AkaG/FTL/DTR/images/silnik-gora.jpg

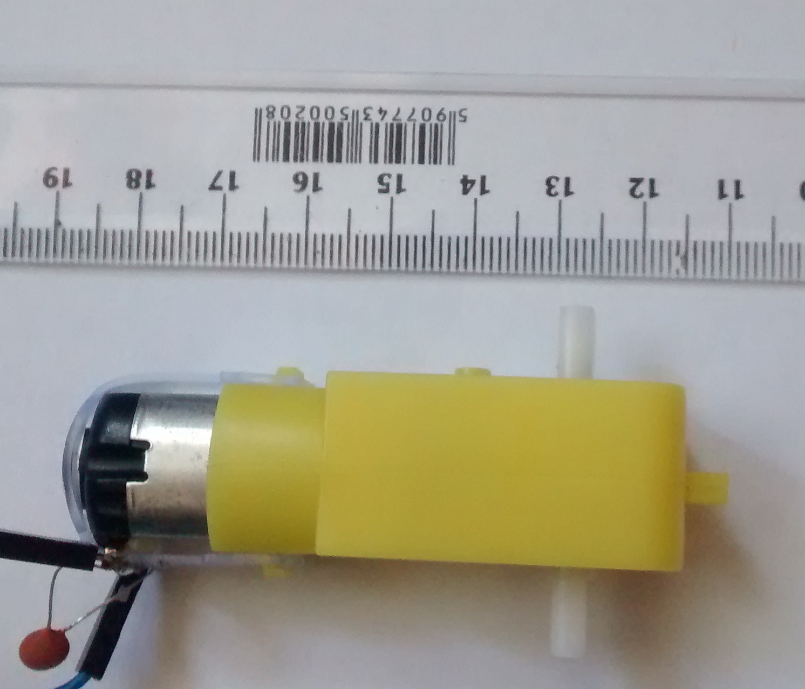
DTR/images/silnik-gora.jpg
