AkaG/FTL/DTR/images/podstawa-3.jpg

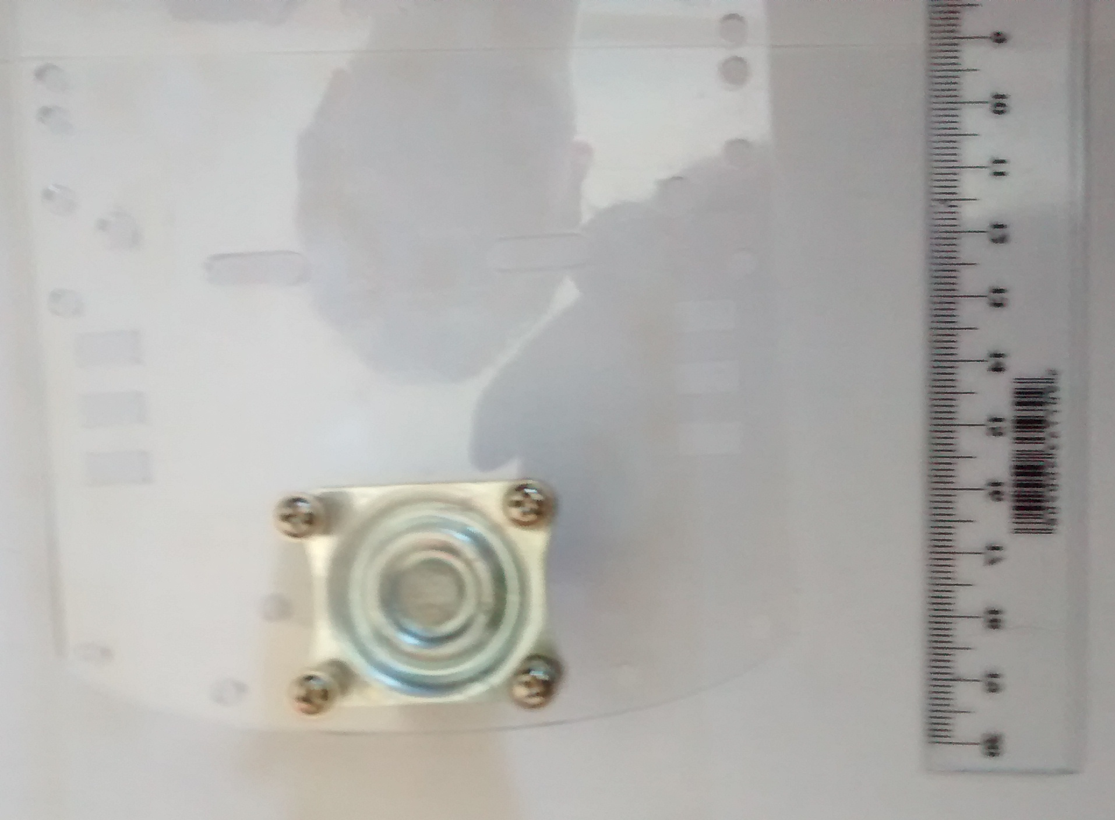
DTR/images/podstawa-3.jpg
