AkaG/FTL/DTR/images/czujnik.jpg

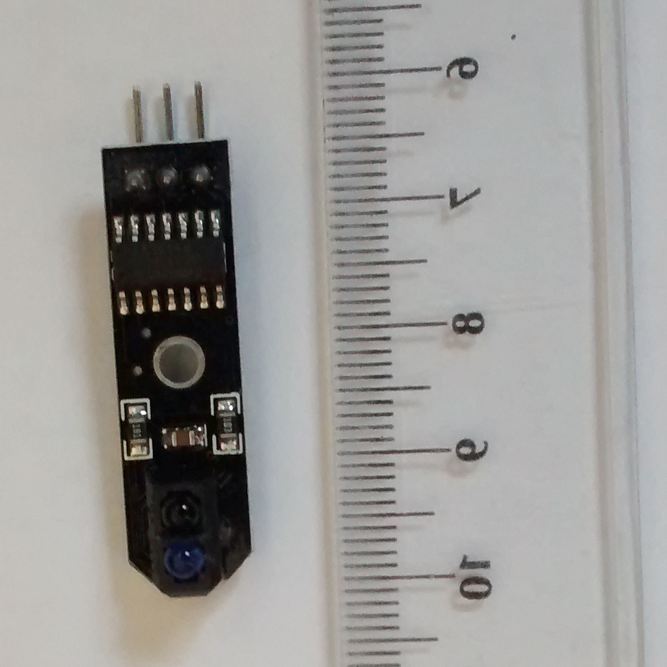
DTR/images/czujnik.jpg
