AkaG/FTL/DTR/images/FTL-B.png

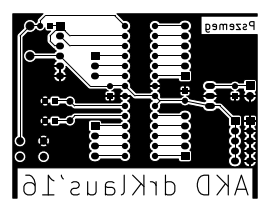
DTR/images/FTL-B.png
