AkaG/FTL/DTR/images/kolo.jpg

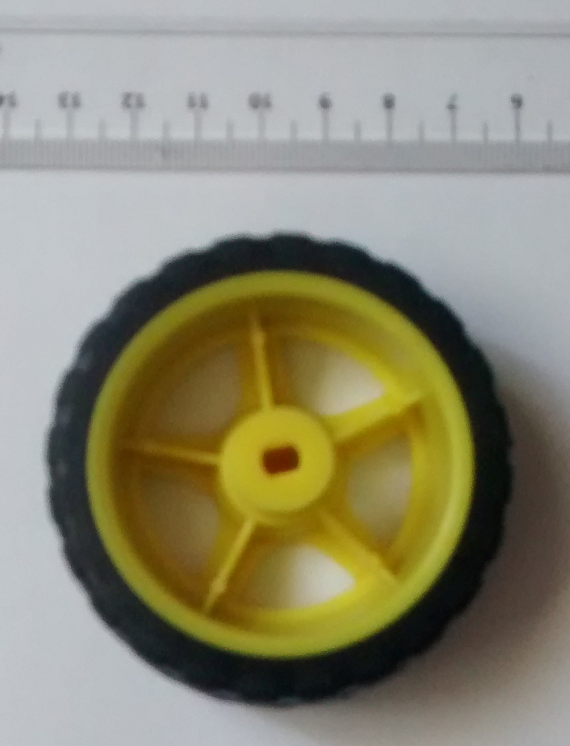
DTR/images/kolo.jpg
