AkaG/FTL/DTR/images/mocowanieCzujnika.jpg

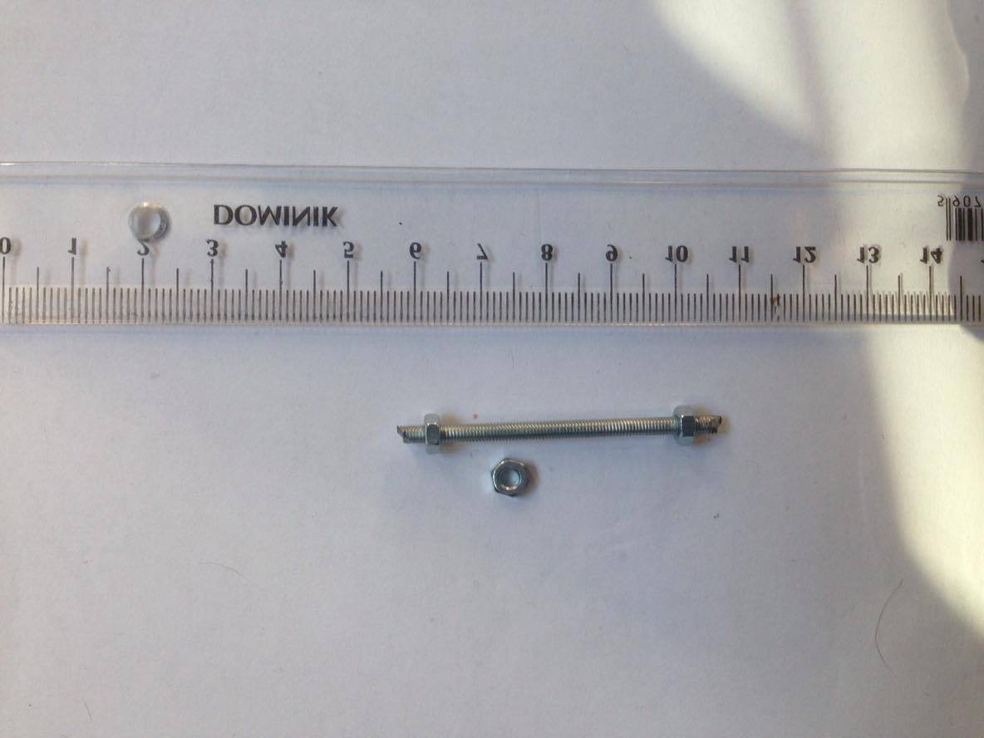
DTR/images/mocowanieCzujnika.jpg
