AkaG/FTL/DTR/images/mocowanieSilnika.jpg

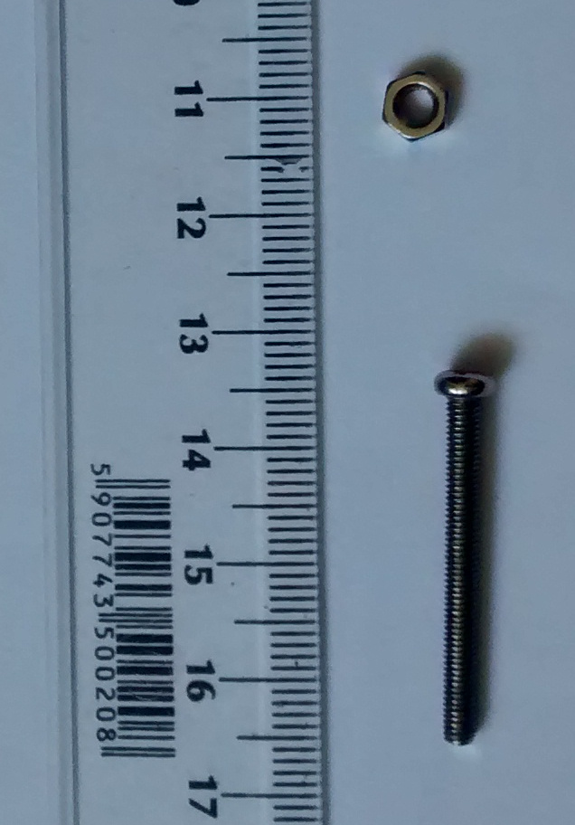
DTR/images/mocowanieSilnika.jpg
