AkaG/FTL/DTR/images/mostek.jpg

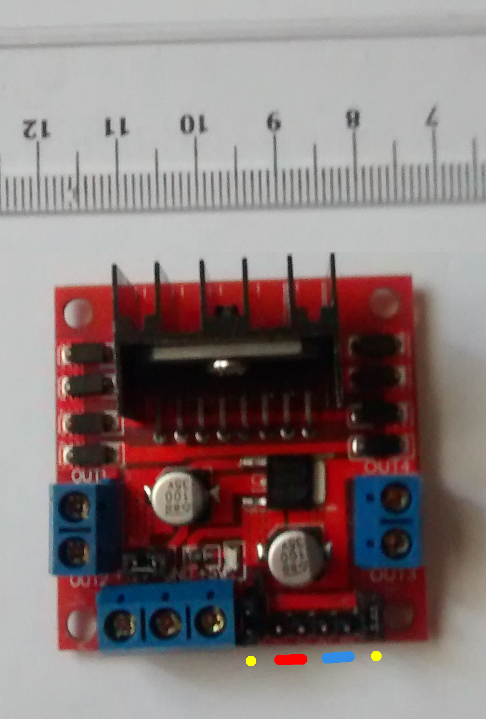
DTR/images/mostek.jpg
