AkaG/FTL/DTR/images/pcb.PNG

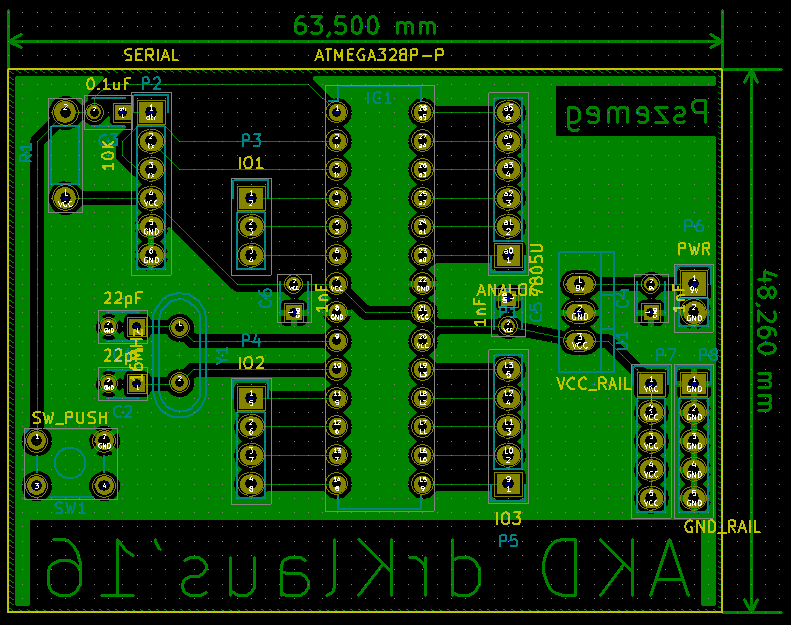
DTR/images/pcb.PNG
