AkaG/FTL/DTR/images/plytka.jpg

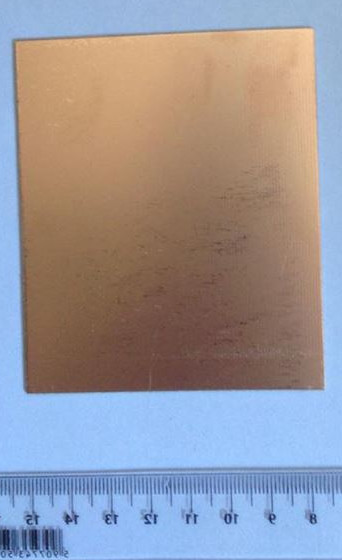
DTR/images/plytka.jpg
