AkaG/FTL/DTR/images/plytkaGotowa.jpg

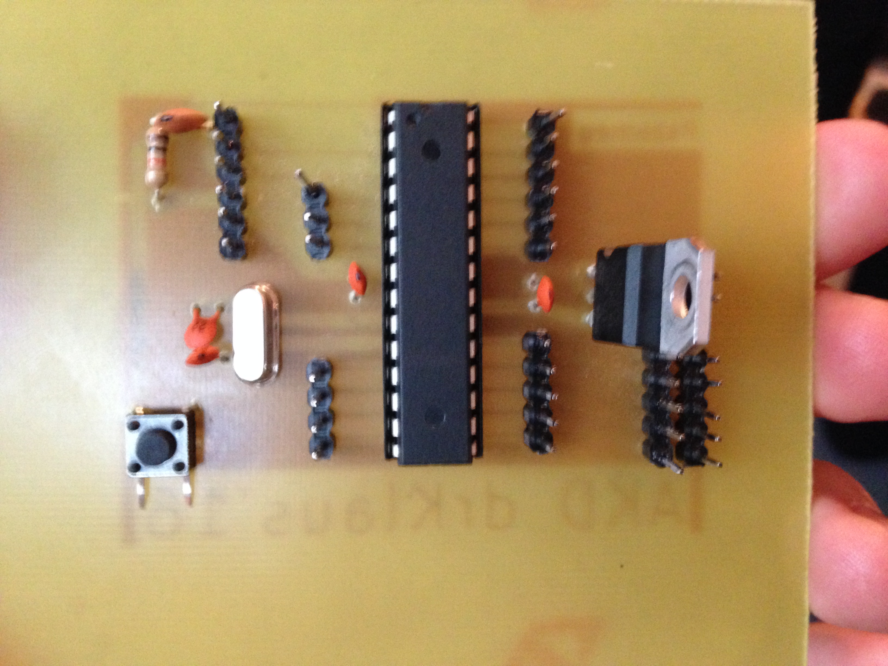
DTR/images/plytkaGotowa.jpg
