AkaG/FTL/DTR/images/podstawa-1.jpg

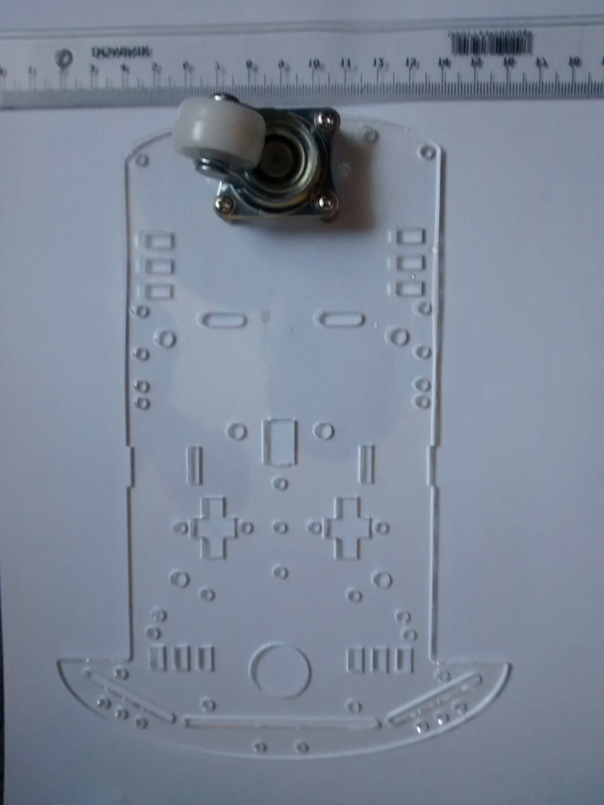
DTR/images/podstawa-1.jpg
