AkaG/FTL/DTR/images/podstawa-2.jpg

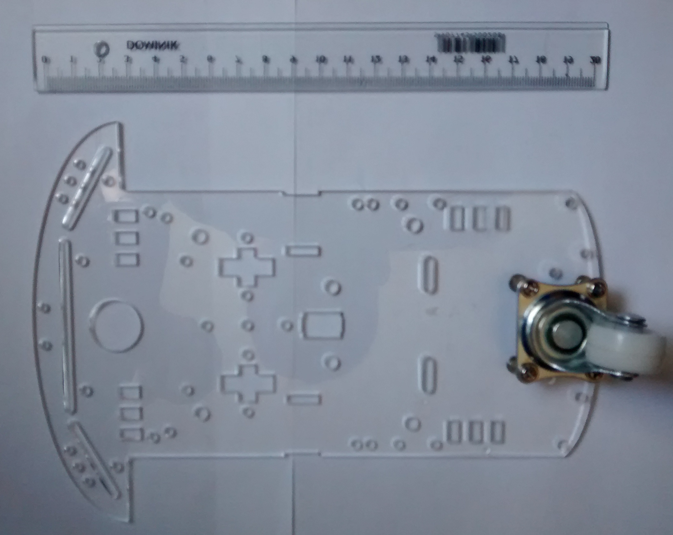
DTR/images/podstawa-2.jpg
