AkaG/FTL/DTR/images/podstawa-4.jpg

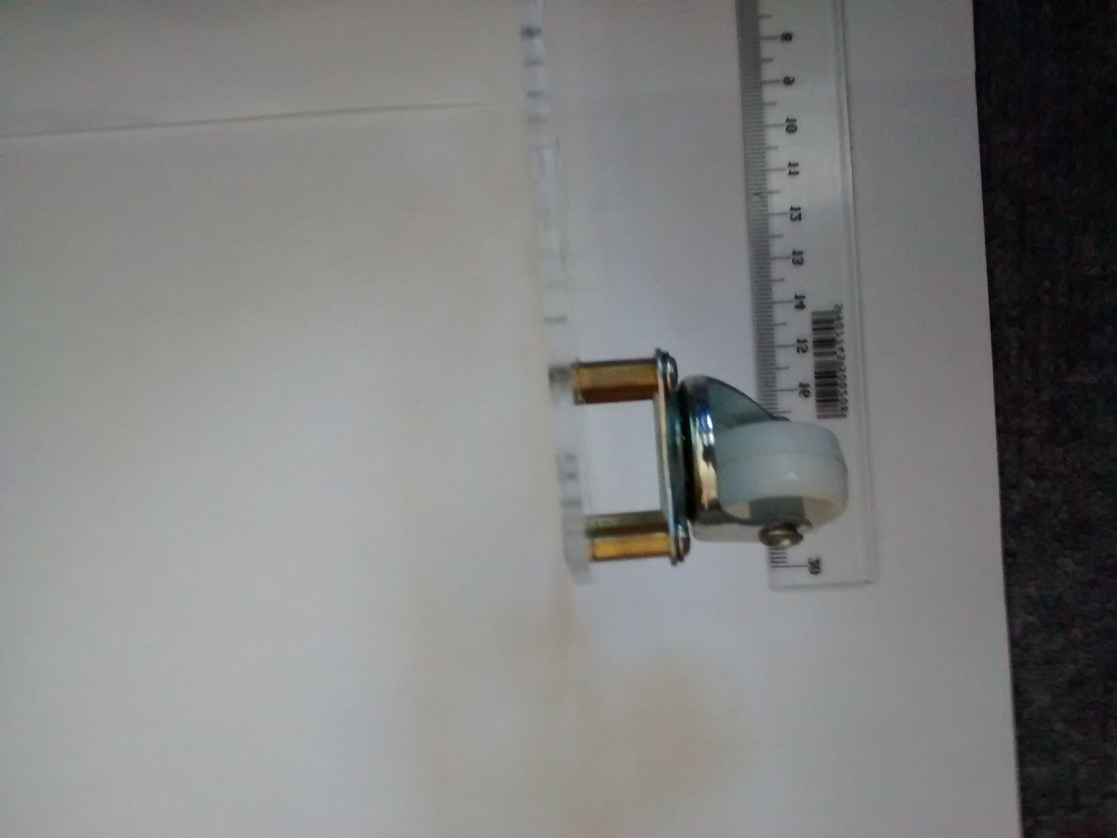
DTR/images/podstawa-4.jpg
