AkaG/FTL/DTR/images/pojemnik-1.jpg

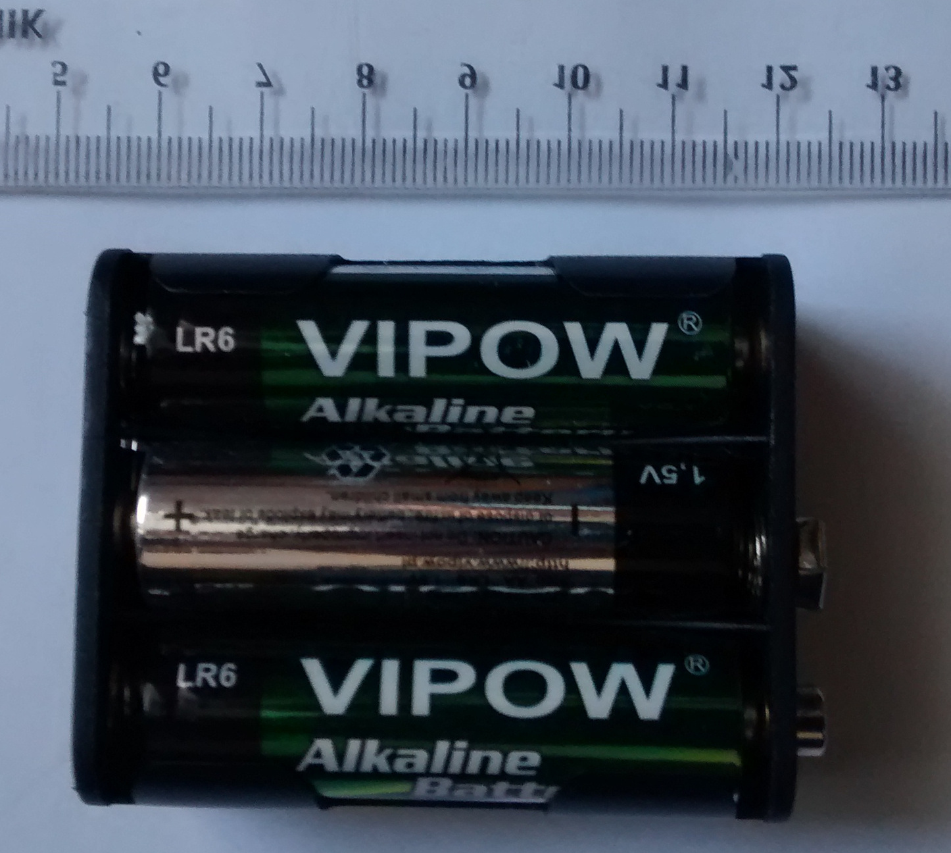
DTR/images/pojemnik-1.jpg
