AkaG/FTL/DTR/images/pojemnik-2.jpg

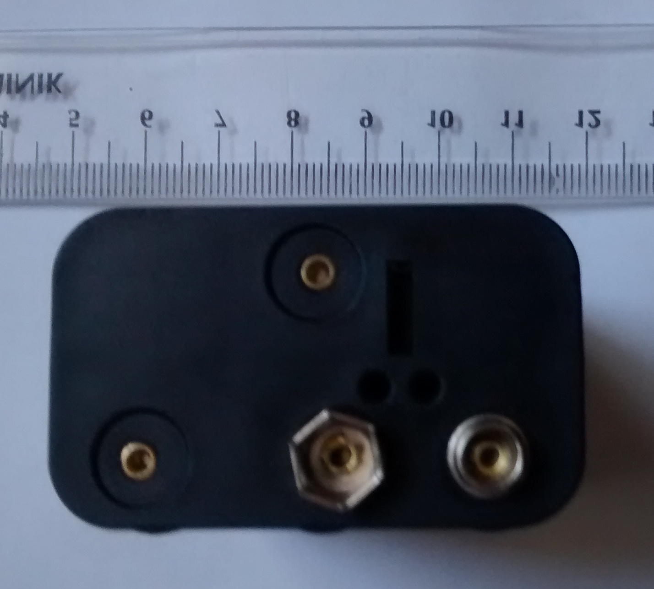
DTR/images/pojemnik-2.jpg
