AkaG/FTL/DTR/images/Pszemeg.jpg

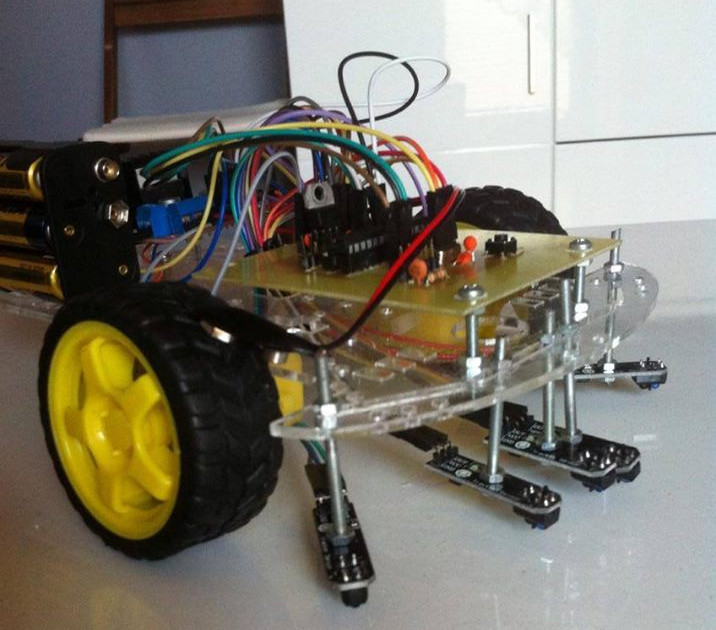
DTR/images/Pszemeg.jpg
