AkaG/FTL/DTR/images/schemat.PNG

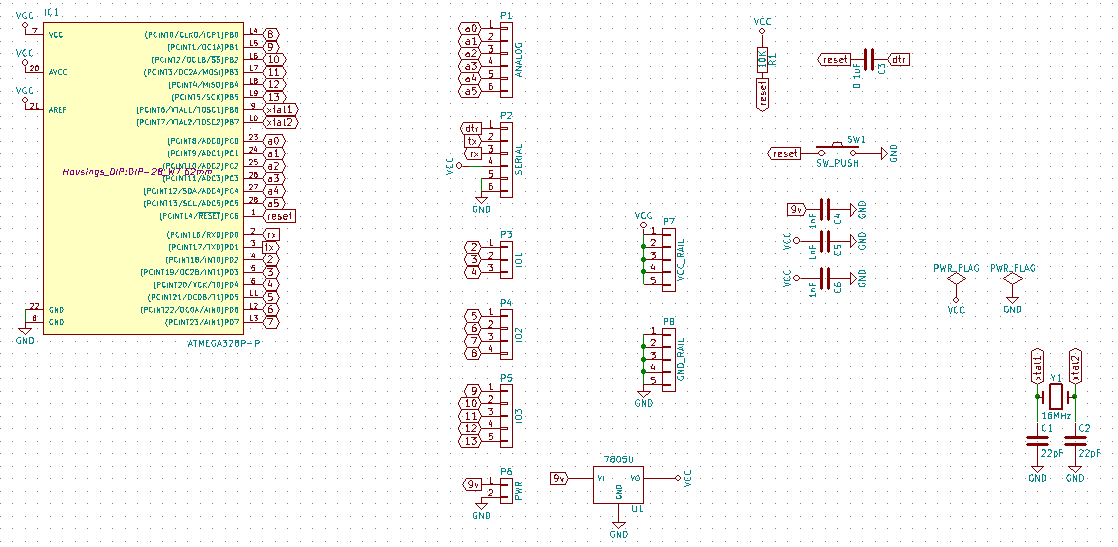
DTR/images/schemat.PNG
