AkaG/FTL/DTR/images/silnik-bok.jpg

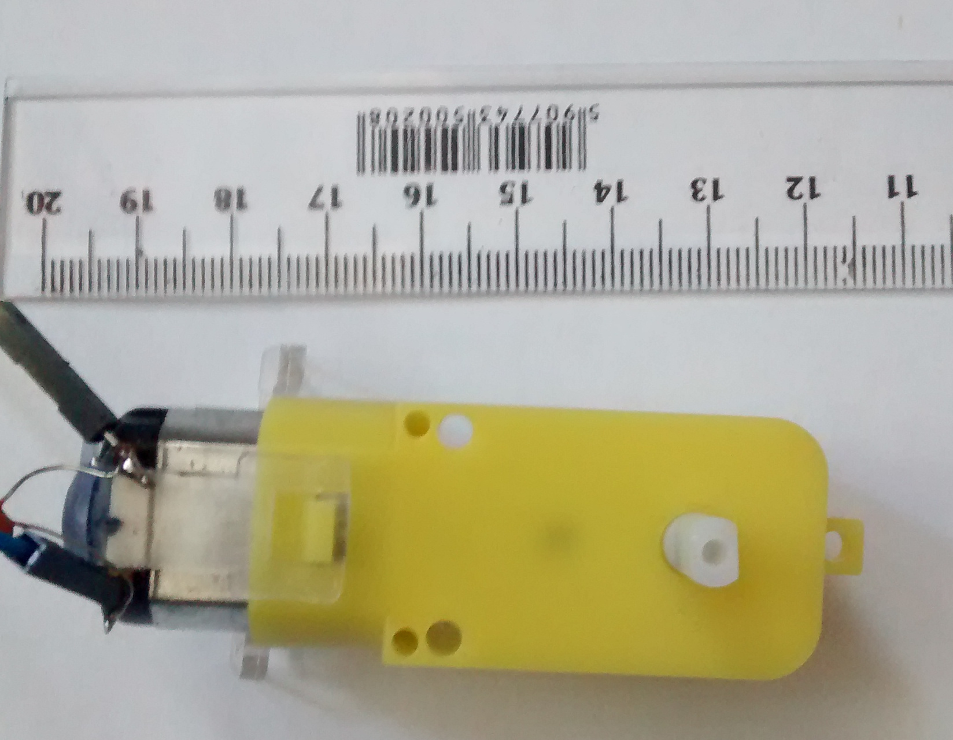
DTR/images/silnik-bok.jpg
