AkaG/FTL/DTR/images/temp.png

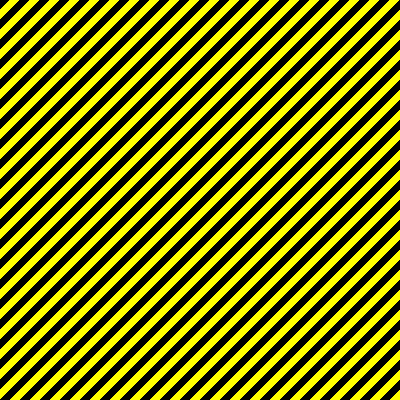
DTR/images/temp.png
