AkaG/FTL/DTR/images/termotransfer-1.jpg

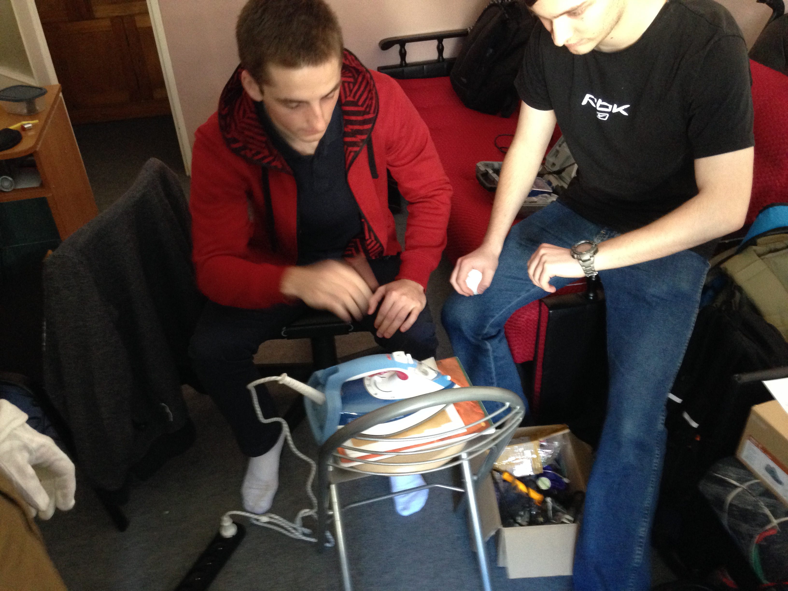
DTR/images/termotransfer-1.jpg
