AkaG/FTL/DTR/images/trzymacze.jpg

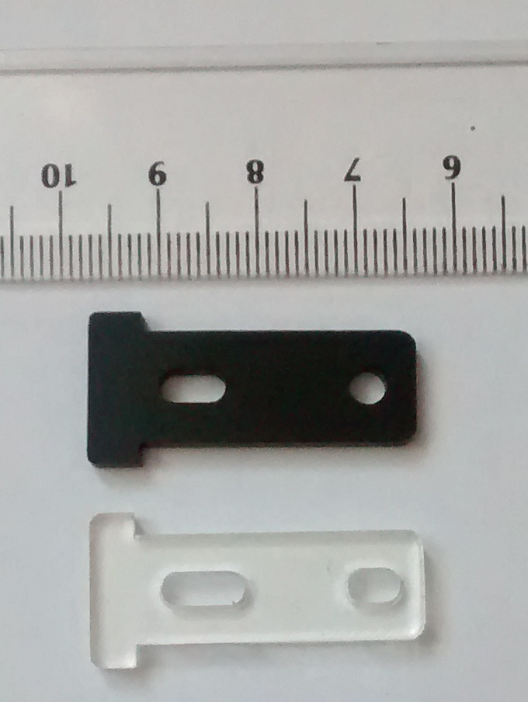
DTR/images/trzymacze.jpg
