AkaG/FTL/DTR/images/wanienka.jpg

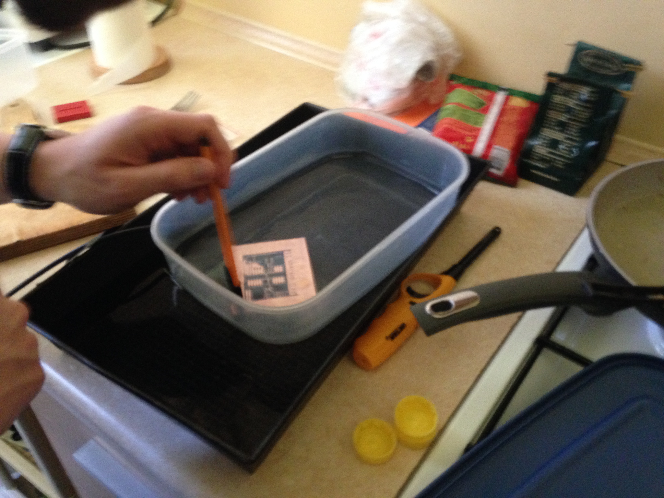
DTR/images/wanienka.jpg
