AkaG/FTL/DTR/images/wiercenie.jpg

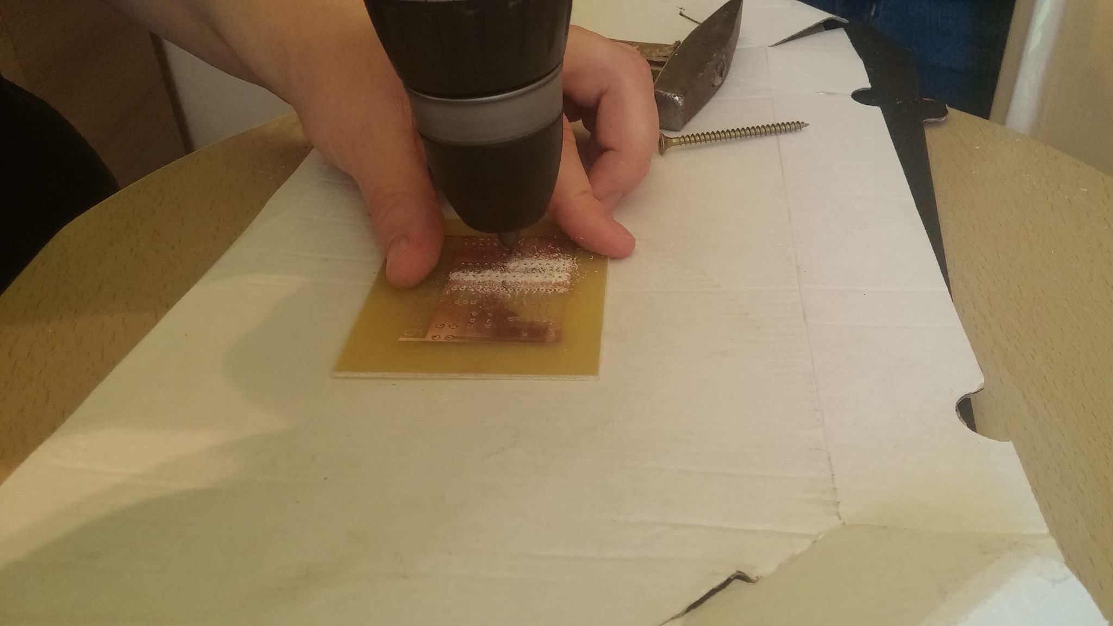
DTR/images/wiercenie.jpg
