AkaG/FTL/DTR/images/ZabrudzeniaKreda.png

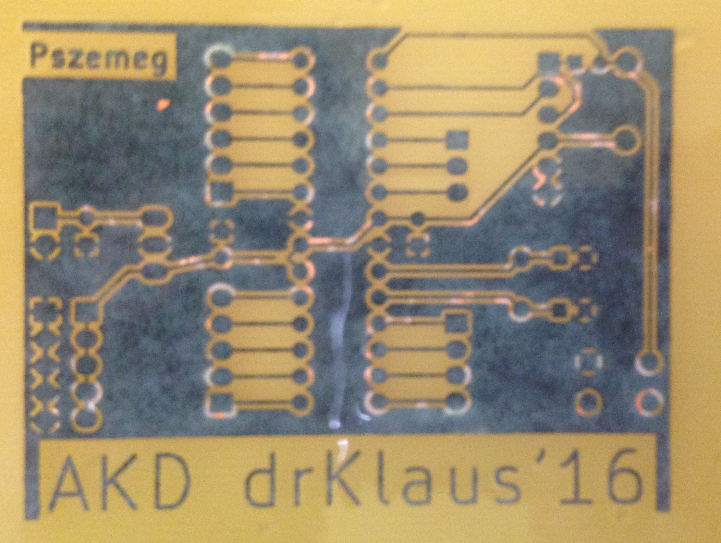
DTR/images/ZabrudzeniaKreda.png
