AkaG/FTL/DTR/images/zlaczka.jpg

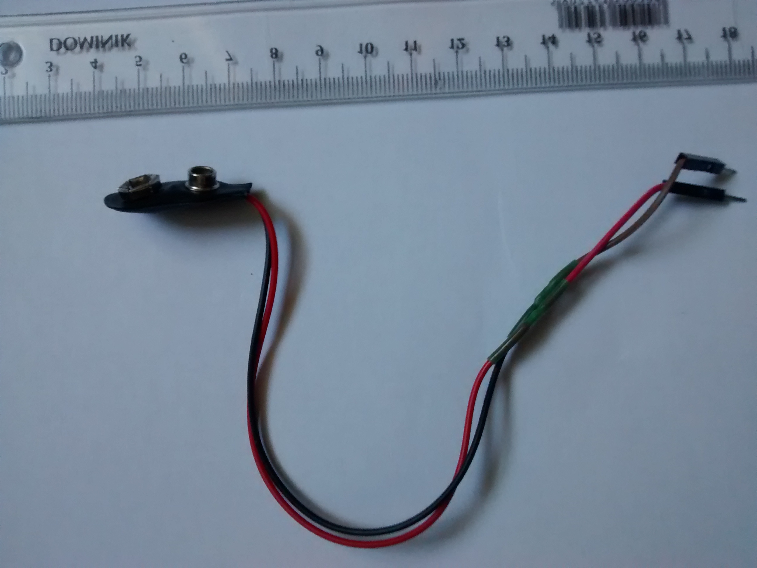
DTR/images/zlaczka.jpg
