AkaG/FTL/DTR/FTL-B.pdf

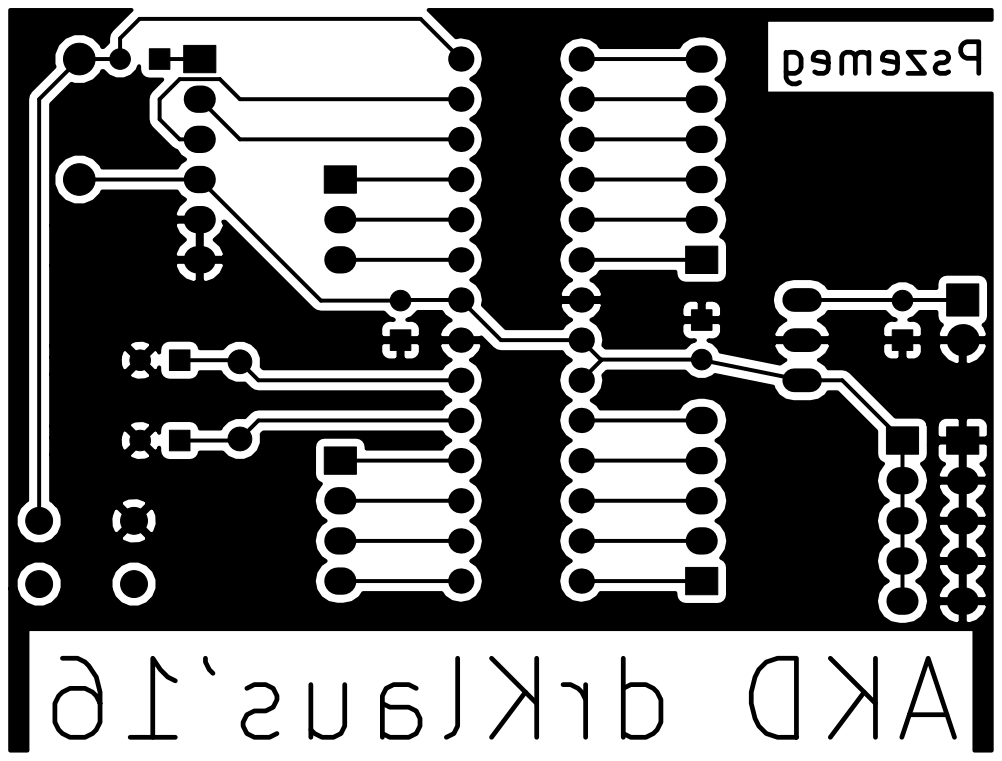
[picture p27: page 1]
